nehirakdag/Drumduino/Images/draft.jpg

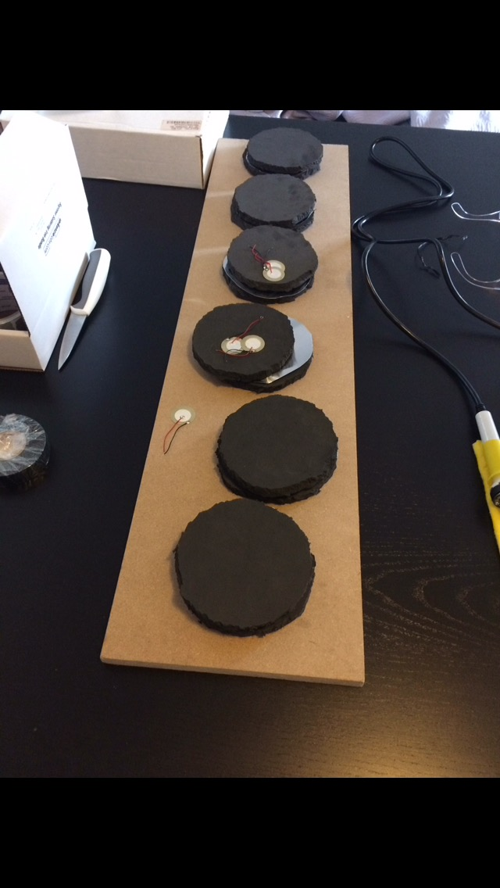
Images/draft.jpg
