nehirakdag/Drumduino/Images/Metronome_circuit.jpg

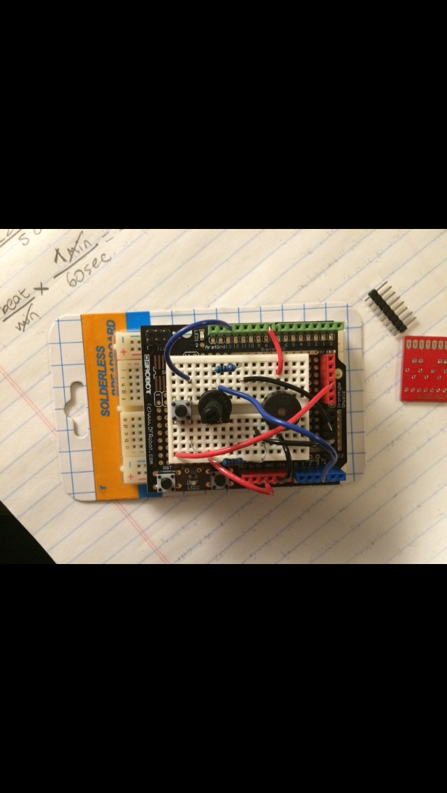
Images/Metronome_circuit.jpg
